onurtoprak1/EE463_PROJECT/Topology of a Simple Battery.png

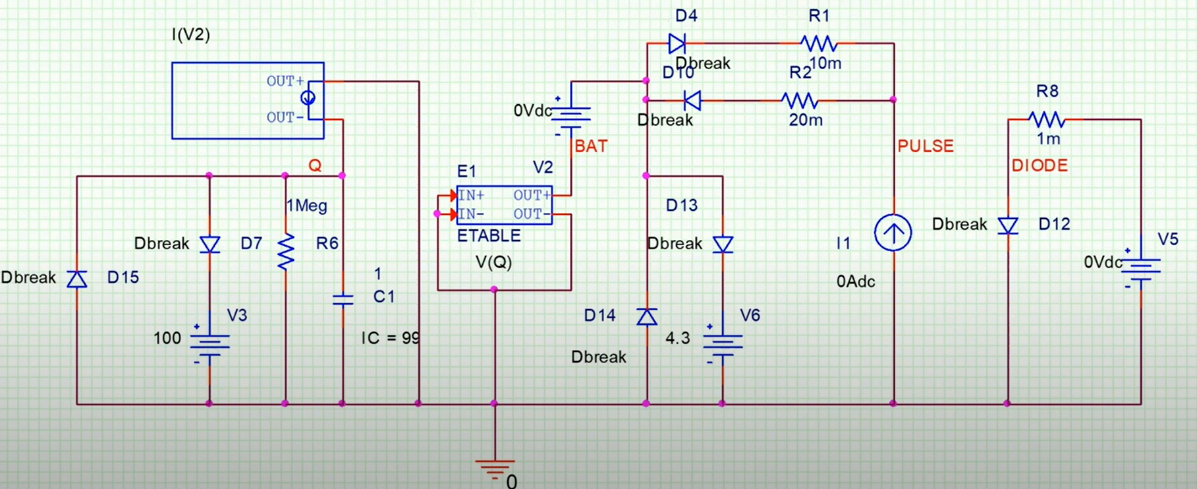
Topology of a Simple Battery.png
