onurtoprak1/EE463_PROJECT/README.md

# EE463_PROJECT
EE463_PROJECT
Advantages and Disadvantages of Three-Phase Thyristor Rectifier Topology:
When it comes to charging batteries, a three-phase thyristor rectifier circuit offers both benefits and drawbacks. On the plus side, it boasts a high efficiency in converting AC to DC power, which reduces energy losses and produces a smoother DC output. Additionally, three-phase rectifiers have a higher power factor and can handle high power loads, making them ideal for applications with substantial power consumption requirements.

However, these advantages come at a cost. Three-phase rectifier circuits are more complex and require additional components, resulting in increased installation and maintenance expenses. Harmful harmonics can also be introduced into the power system, necessitating extra filtering to meet power quality requirements. The control complexity is likewise higher, requiring precise voltage and current regulation for efficient battery charging. Finally, there are other costs to consider, including total cost, upkeep needs, and possible size and weight increases.

Ultimately, whether to use a single-phase or three-phase rectifier will depend on the specific needs of the application, taking into account factors such as space availability, power requirements, and efficiency.
