onurtoprak1/EE463_PROJECT/final report/Implementation.docx

Implementation

Throughout the project, efforts were made to make the design robust and suitable for daily use. The team considered using a PCB board to do this, but decided not to use it due to limited time and knowledge of PCB design. The fully working version of the circuit was tested in various simulation programs and then implemented. The location of the components was determined and optimum lengths were tried to be selected in terms of signal transmission. Heat sinks were adjusted by paying attention to thermal calculations, but the component positions on the stripboard could not be completed in time and soldered in a neat position due to limited time and the difficulties of pure analog design. Under these conditions, the overall circuit, rectifier - controller and output parts were positioned on separate pertinaxes and taken to the demo in this way.

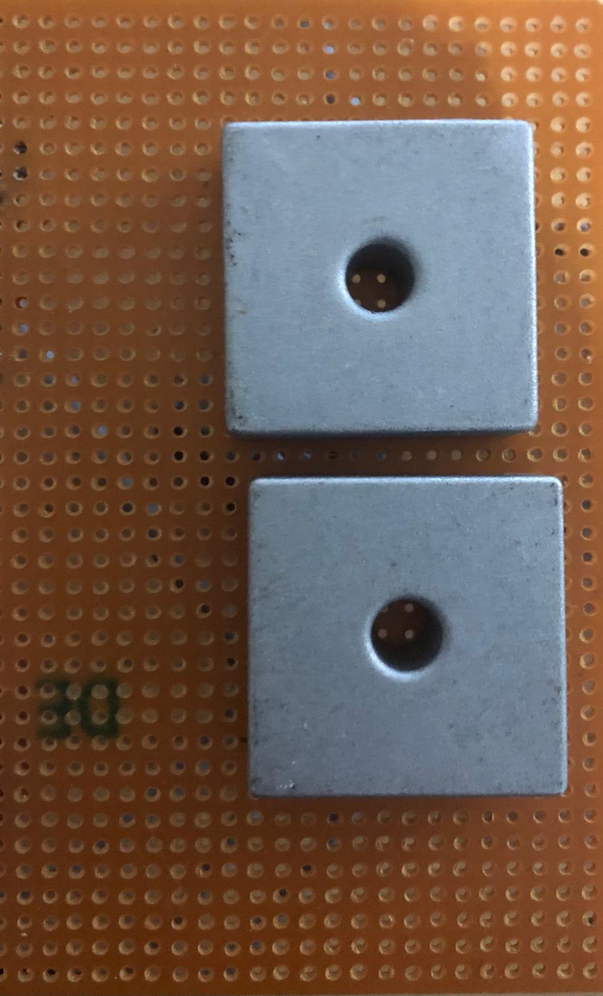
[picture p15: figure]
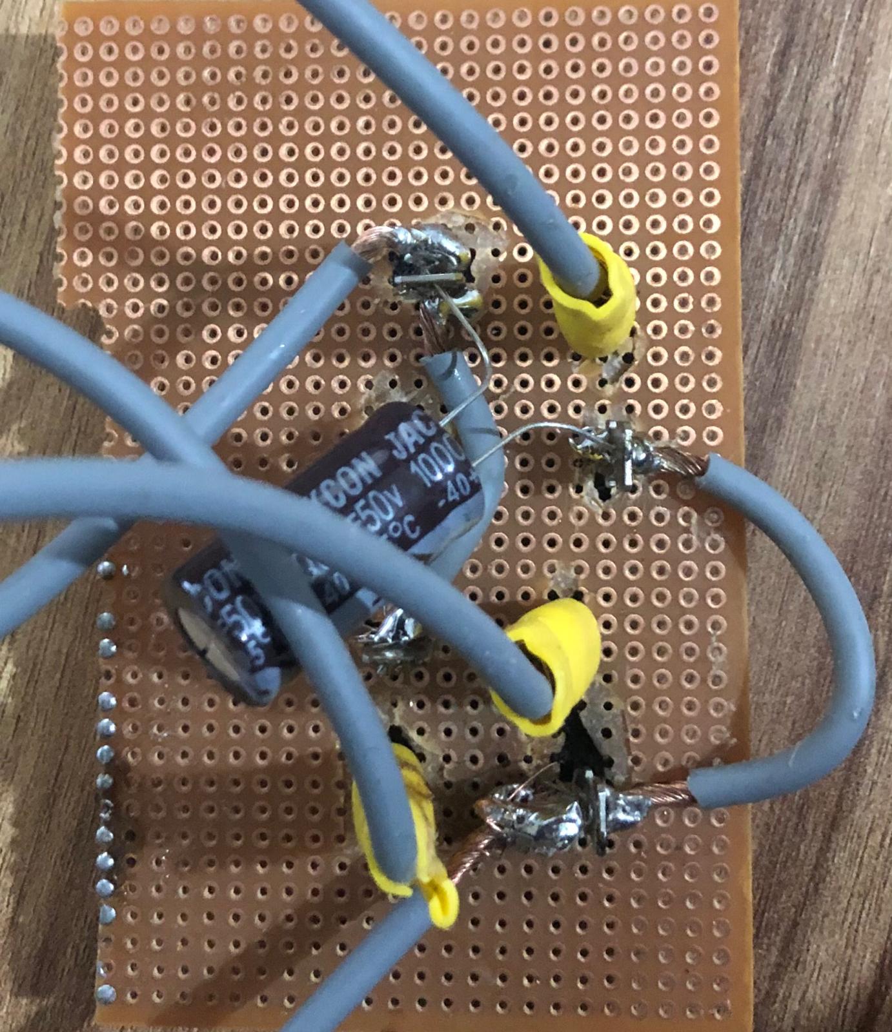
[picture p16: figure]
kablo, Elektrik kabloları, mühendislik, elektronik mühendisliği içeren bir resim Açıklama otomatik olarak oluşturuldu

Figure a. Front and Back Side of Rectifier

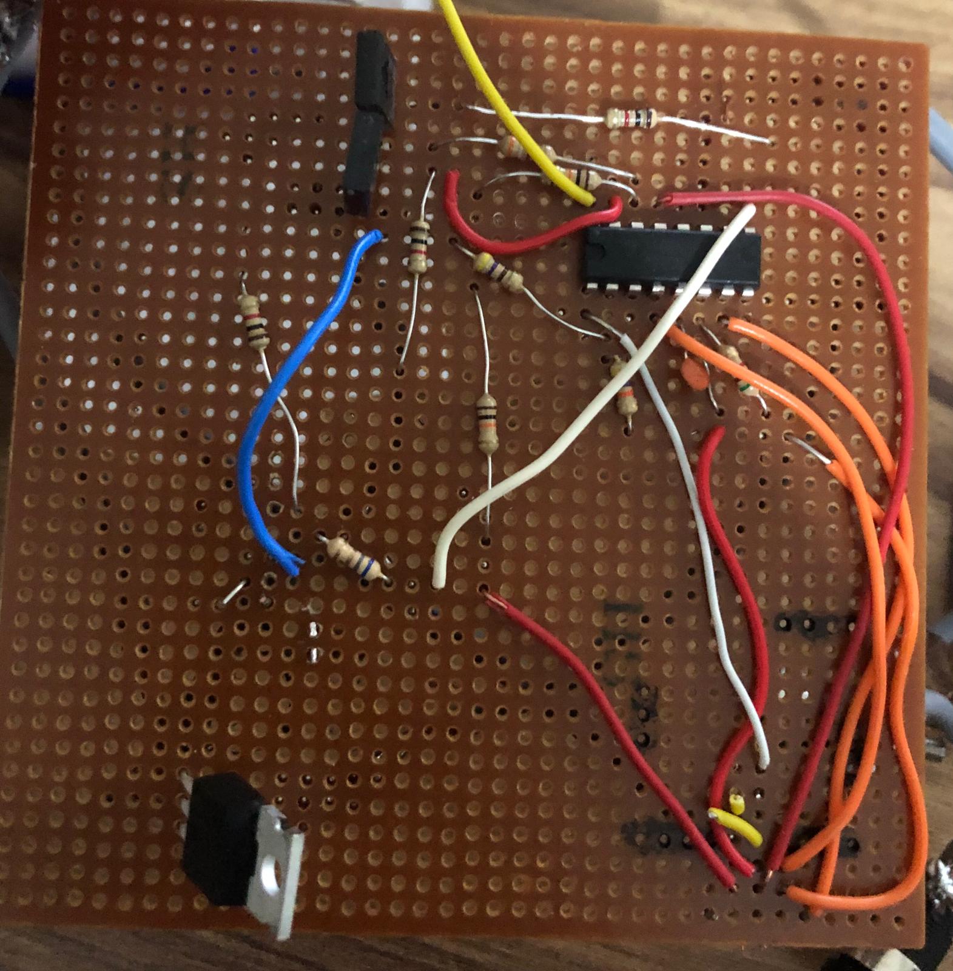
[picture p17: figure]
Elektrik kabloları, elektronik mühendisliği, elektronik donanım, kablo içeren bir resim Açıklama otomatik olarak oluşturuldu

Figure b. Front Side of Controller Part

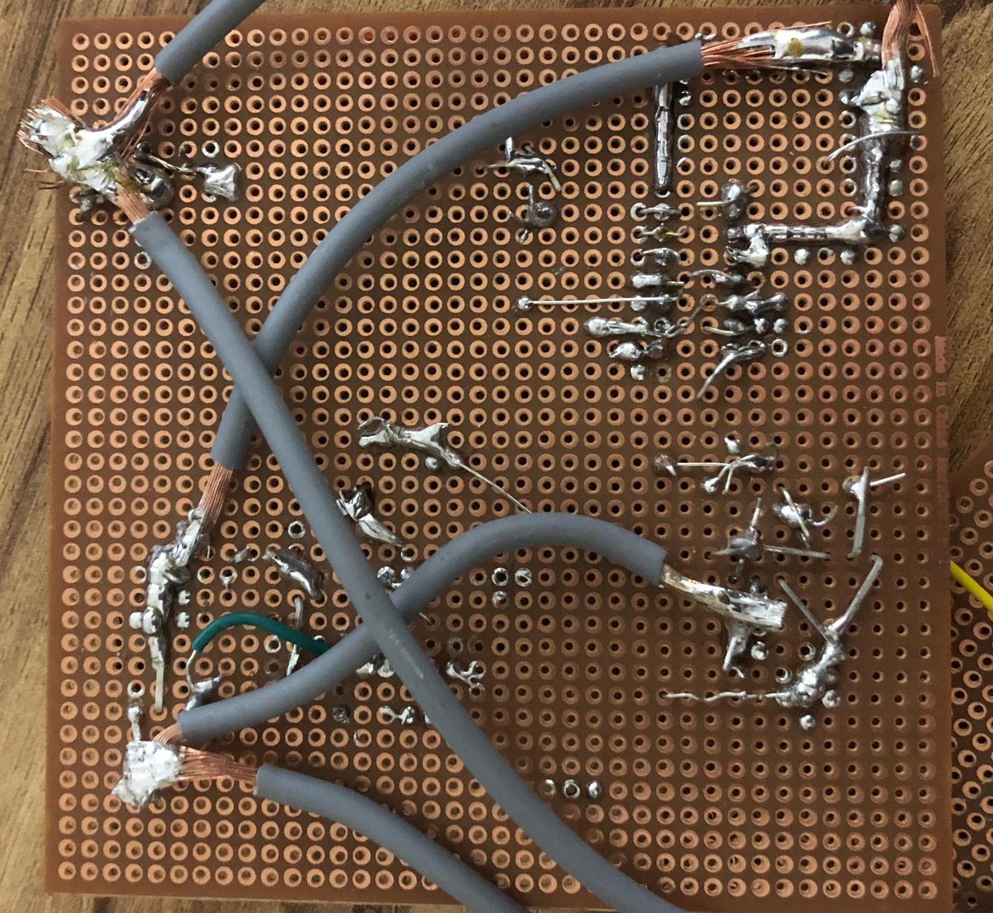
[picture p18: figure]
Elektrik kabloları, elektronik mühendisliği, elektronik bileşen, devre bileşeni içeren bir resim Açıklama otomatik olarak oluşturuldu

Figure c. Back Side of Controller Part

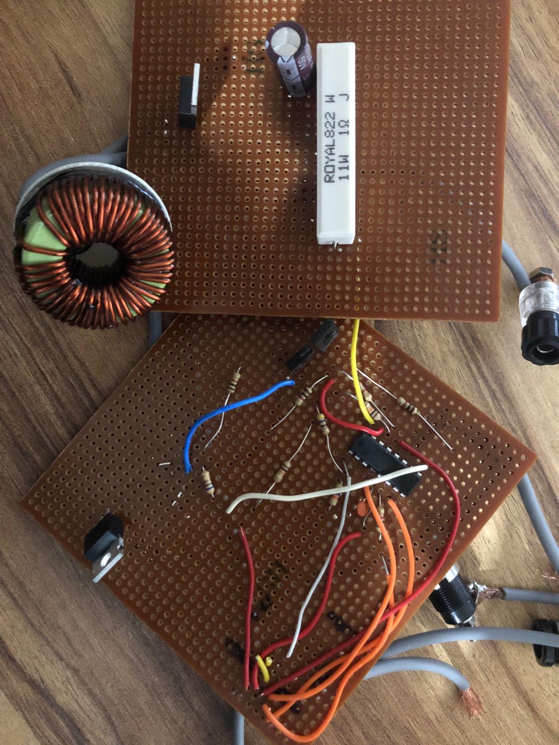
[picture p19: figure]
Elektrik kabloları, elektronik donanım, devre bileşeni, elektronik mühendisliği içeren bir resim Açıklama otomatik olarak oluşturuldu

Figure d. Overall Charger Circuit
