onurtoprak1/EE463_PROJECT/simulation_report/simu presentation.pptx

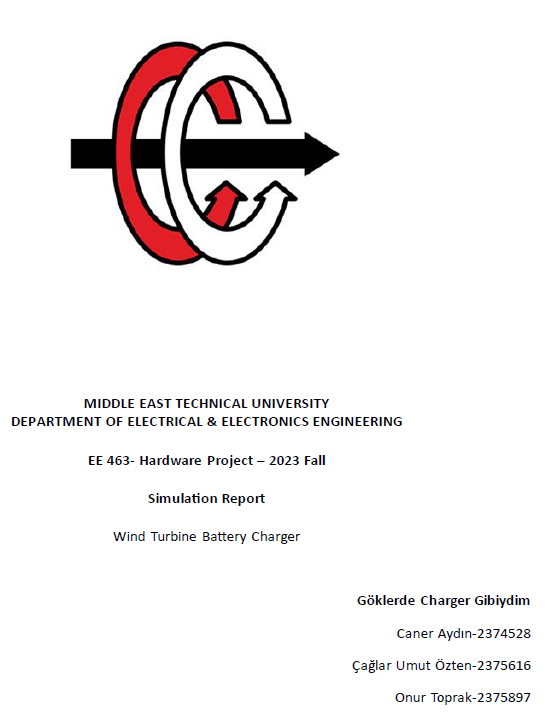
[picture p44: figure]

## OUTLINE

- Battery Illustration
- Topology Selection
- Simulations
- PWM Generator
- Component Selection
- Bonus Parts

## Charging types of battery

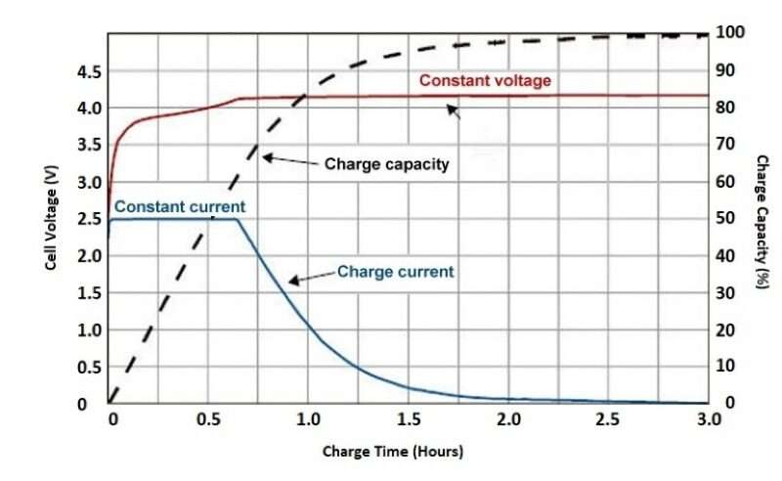
[picture p45: figure]

## Slide 4

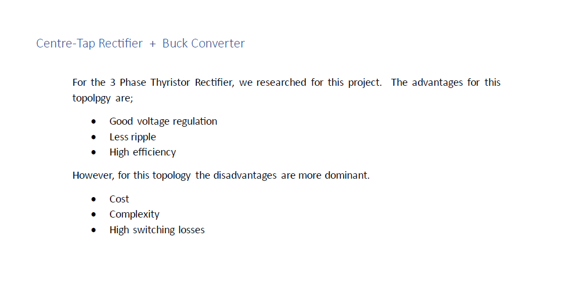
[picture p46: figure]

## Slide 5

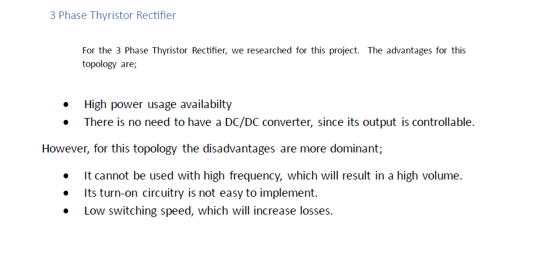
[picture p47: figure]

## Slide 6

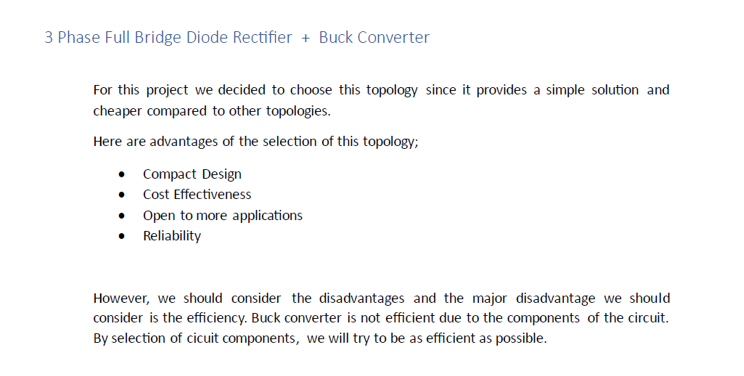
[picture p48: figure]

## Slide 7

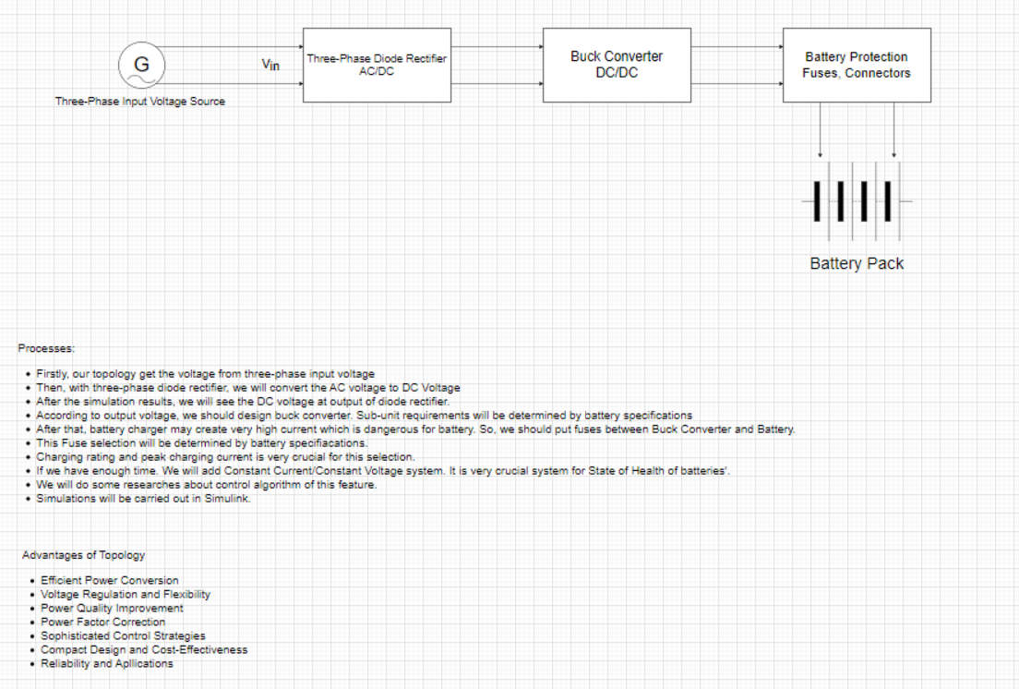
[picture p49: figure]

## Overall Circuit Schematic for Battery Charger

## Diode Current Waveforms (Maximum Input Voltage) and Diode Voltage Waveforms (Maximum Input Voltage)

## Output Voltage Waveforms , Output Voltage Waveforms (Maximum Input Voltage)

## Buck converter circuit

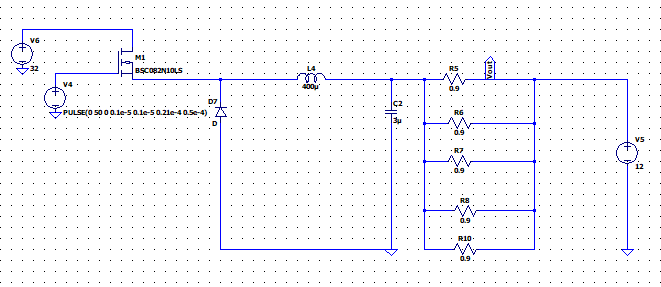
[picture p50: figure]

## Output Voltage Waveform of Buck Converter

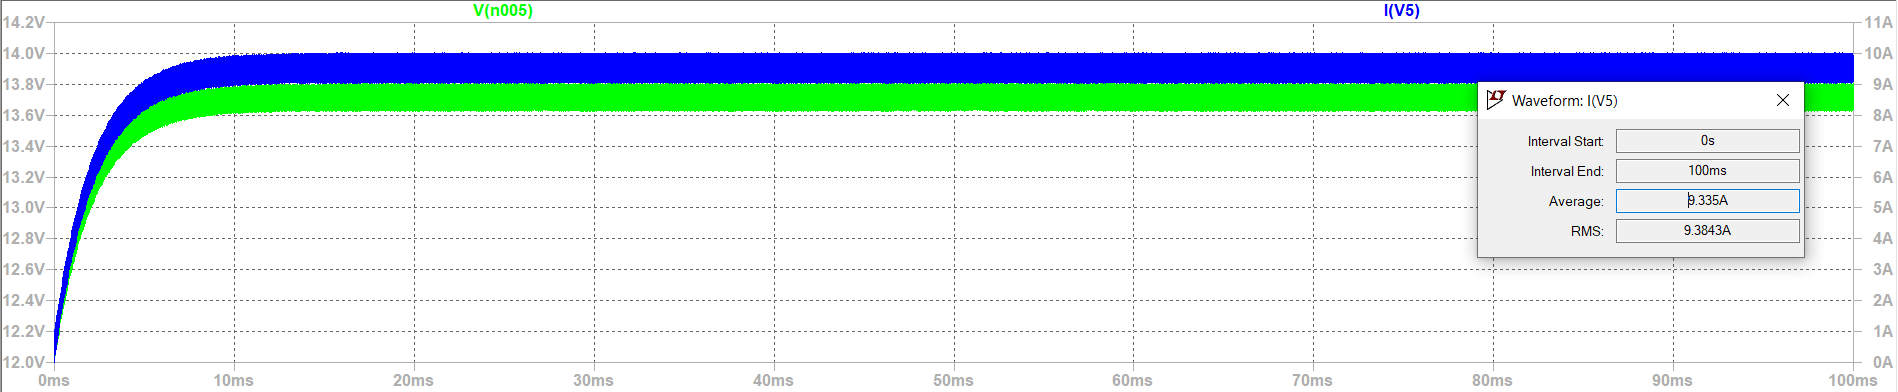
[picture p51: figure]

## Buck Converter Voltage and Current Waveform of Inductor and Diode

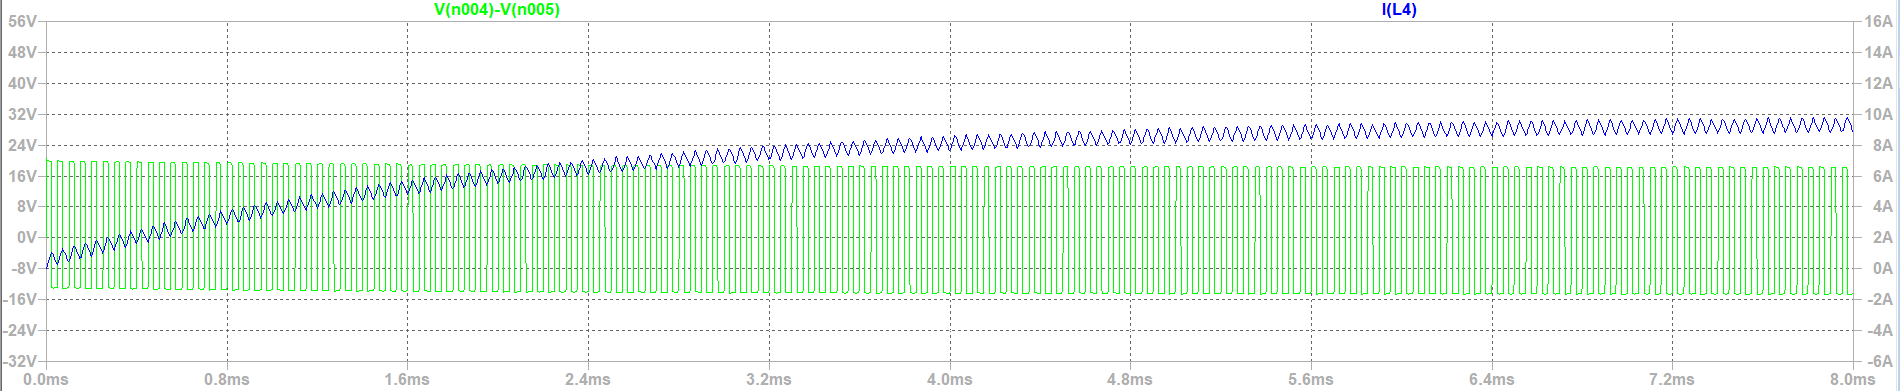
[picture p52: figure]
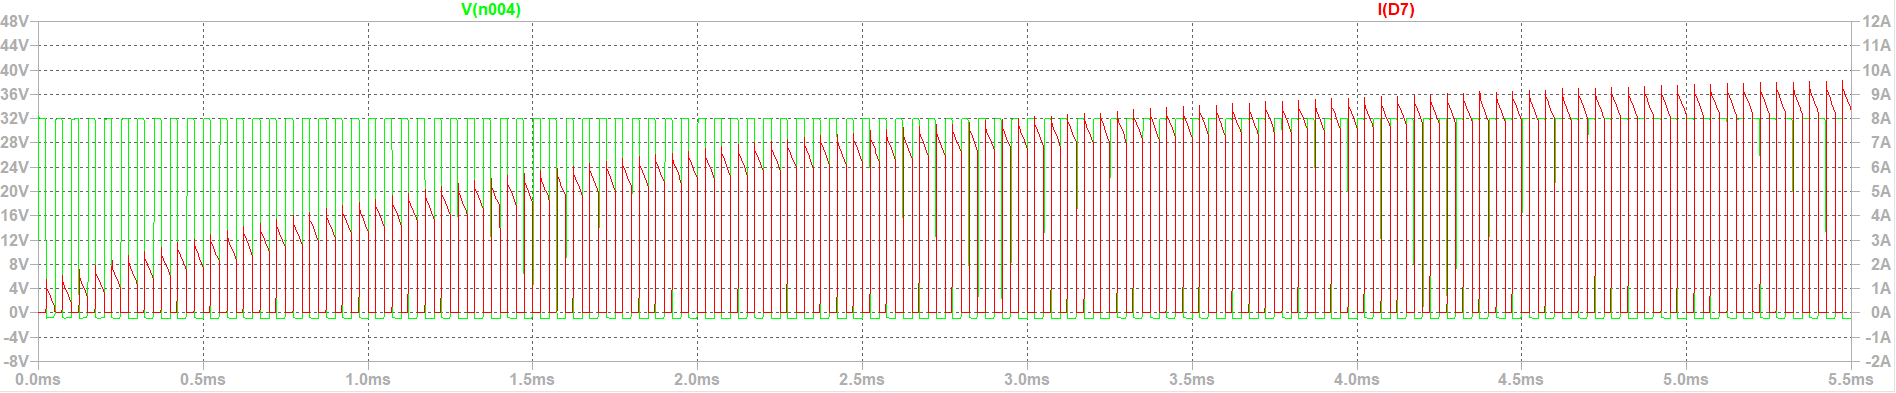
[picture p53: figure]

## MOSFET Current Waveform (Id)

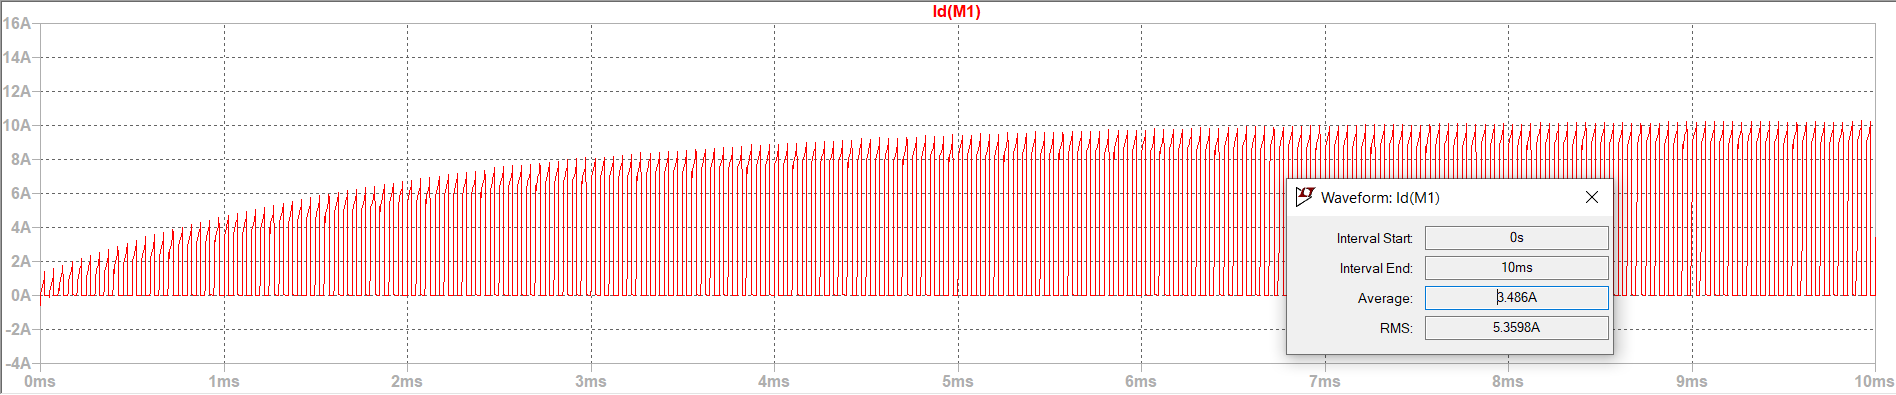
[picture p54: figure]

## Gate Signal

## Timer Circuit LM555

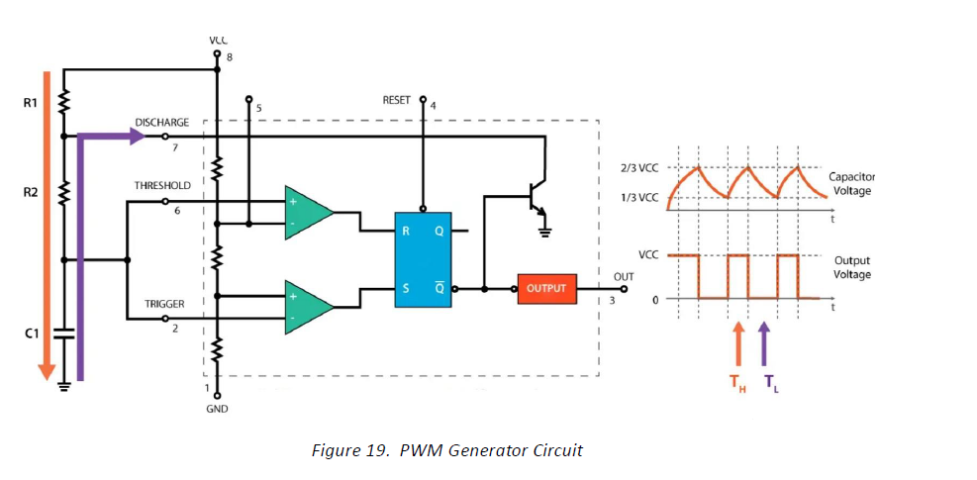
[picture p55: figure]
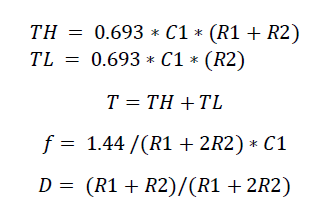
[picture p56: figure]

## Controller Circuit

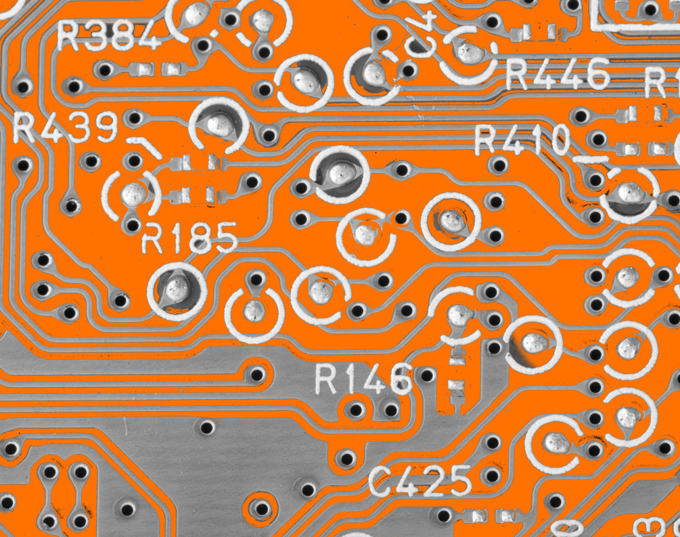
[picture p57: figure]
Electronic circuit board with processor

TL494 VOLTAGE REGULATOR

- Integrated Controller Circuit
- Feedback from battery to keep Id 10 A constant.
- Voltage regulator at the end with resistor or a regulator

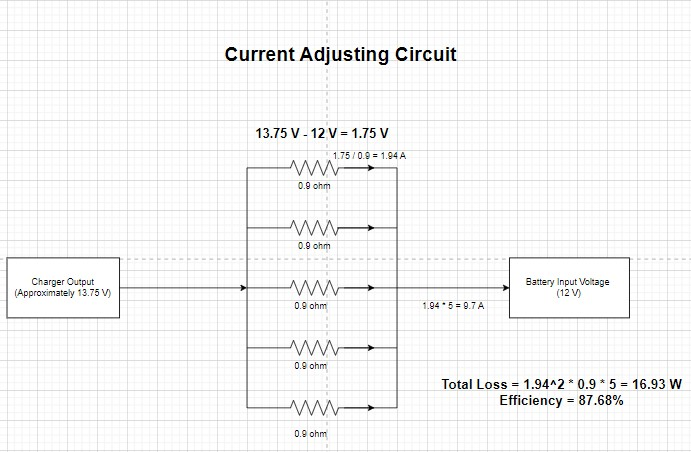
[picture p58: figure]
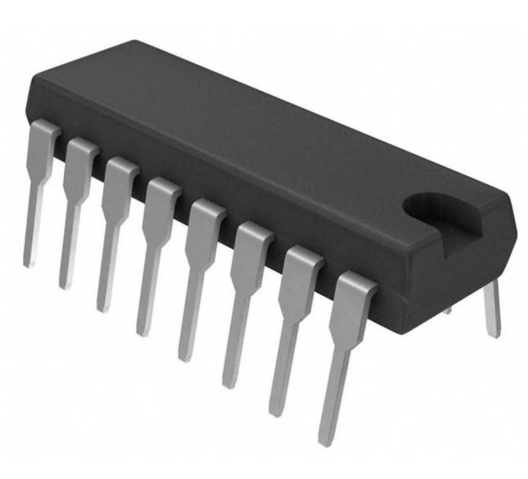
[picture p59: figure]

## Component Selection

- Diode

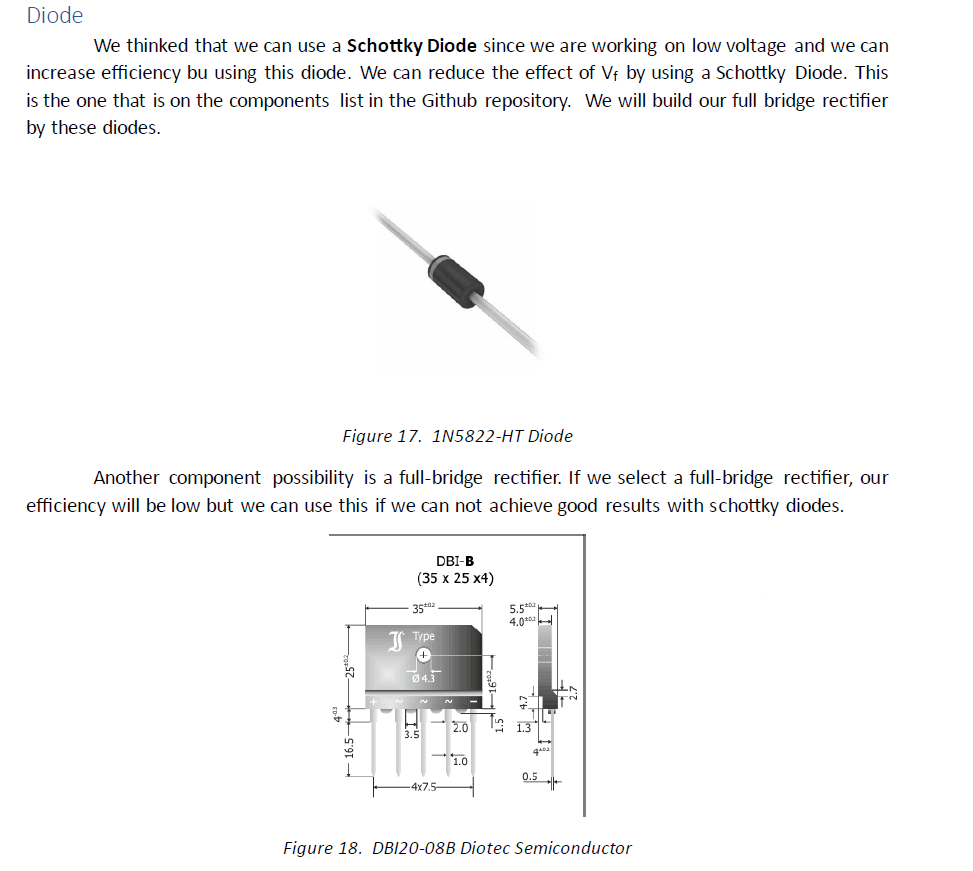
[picture p60: figure]
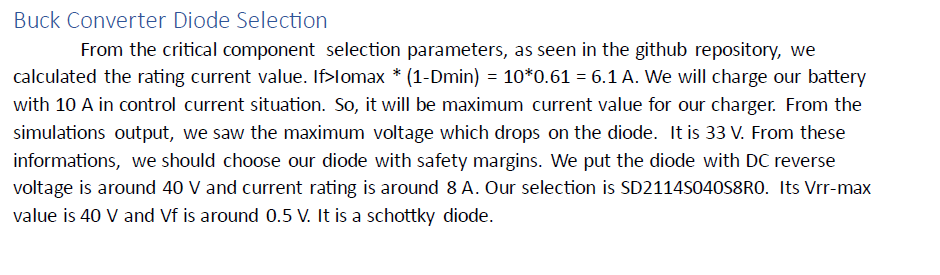
[picture p61: figure]
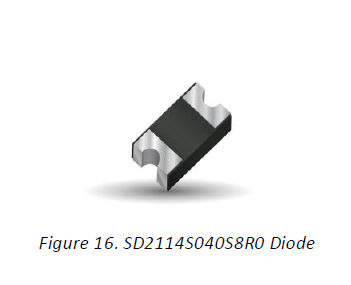
[picture p62: figure]

## BUCK CONVERTER DIODE

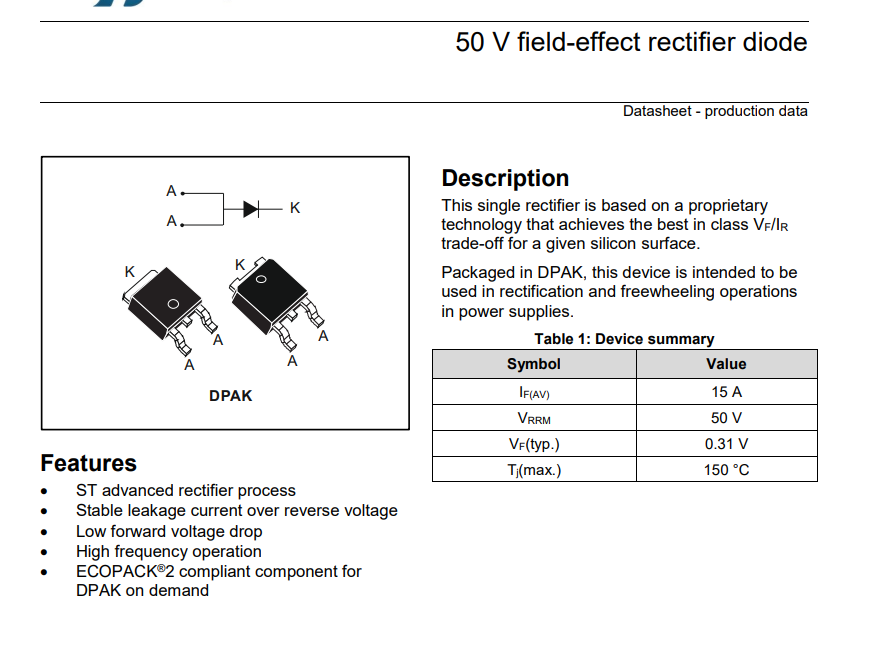
[picture p63: figure]
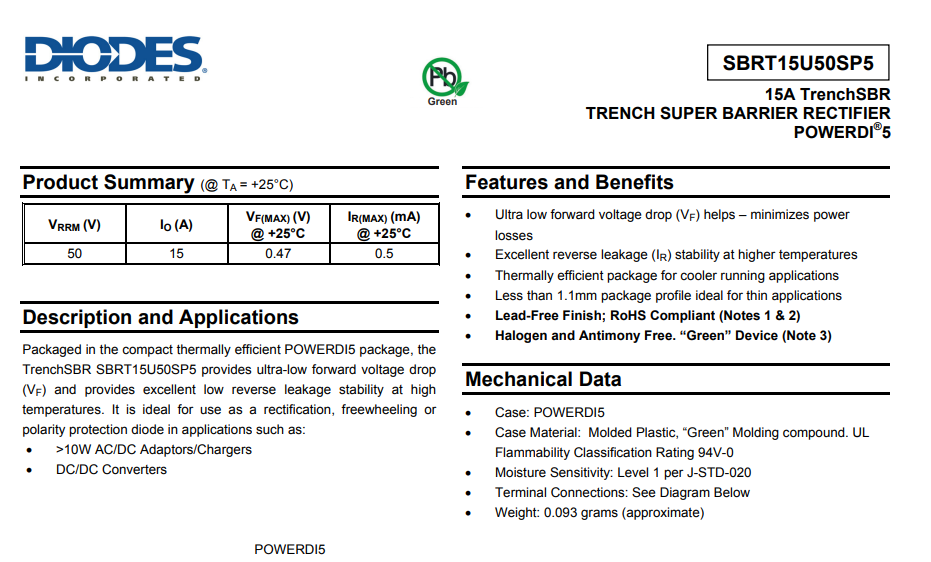
[picture p64: figure]

## Slide 20

- MOSFET

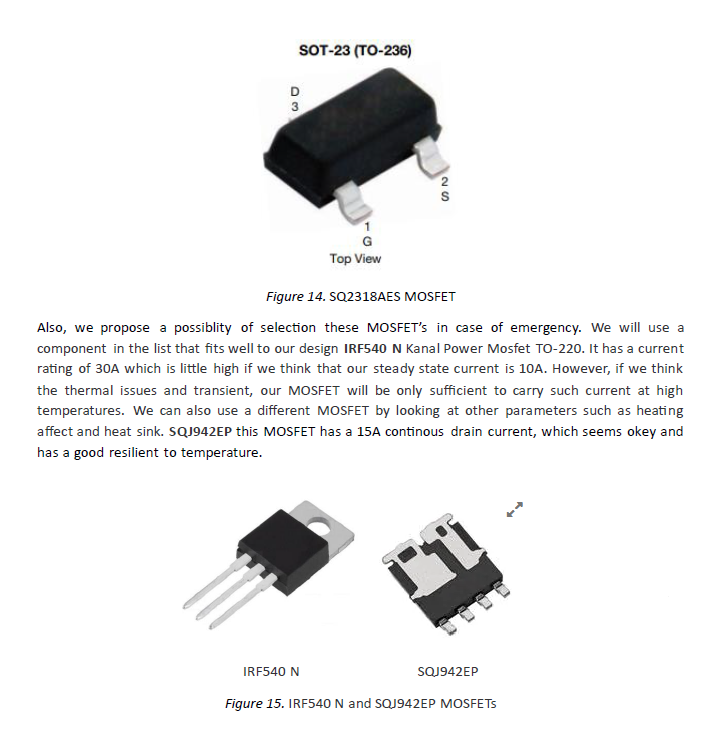
[picture p65: figure]
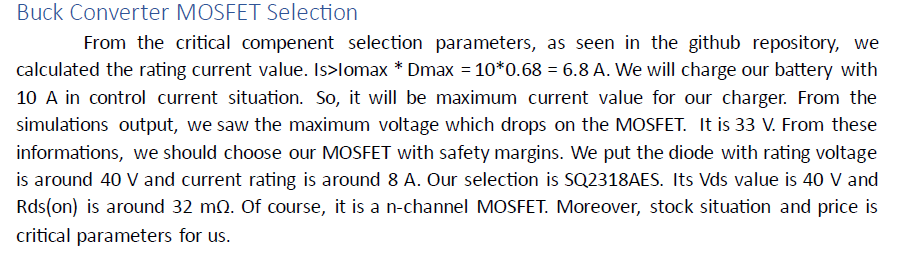
[picture p66: figure]

IRF 540 N Mosfet 100V 28A

## MOSFET

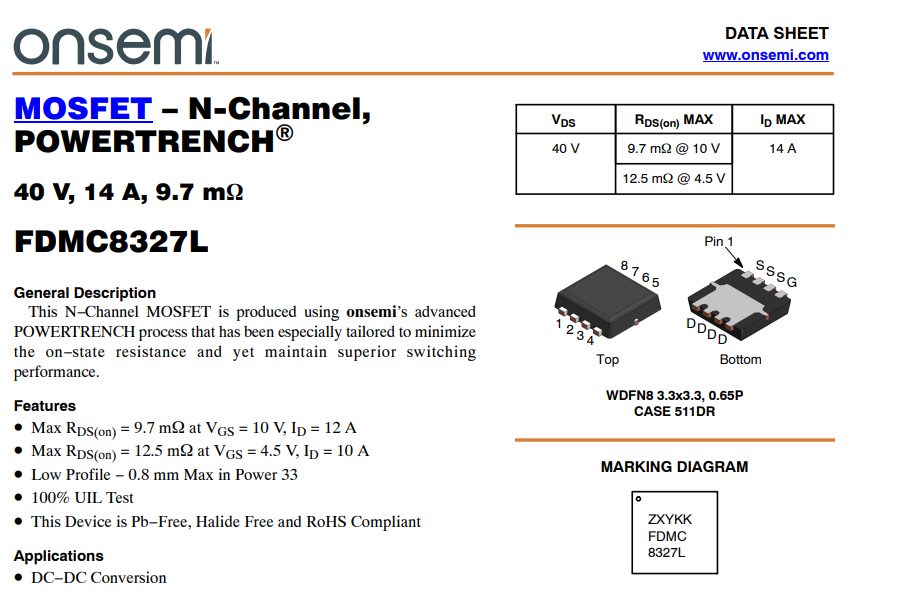
[picture p67: figure]
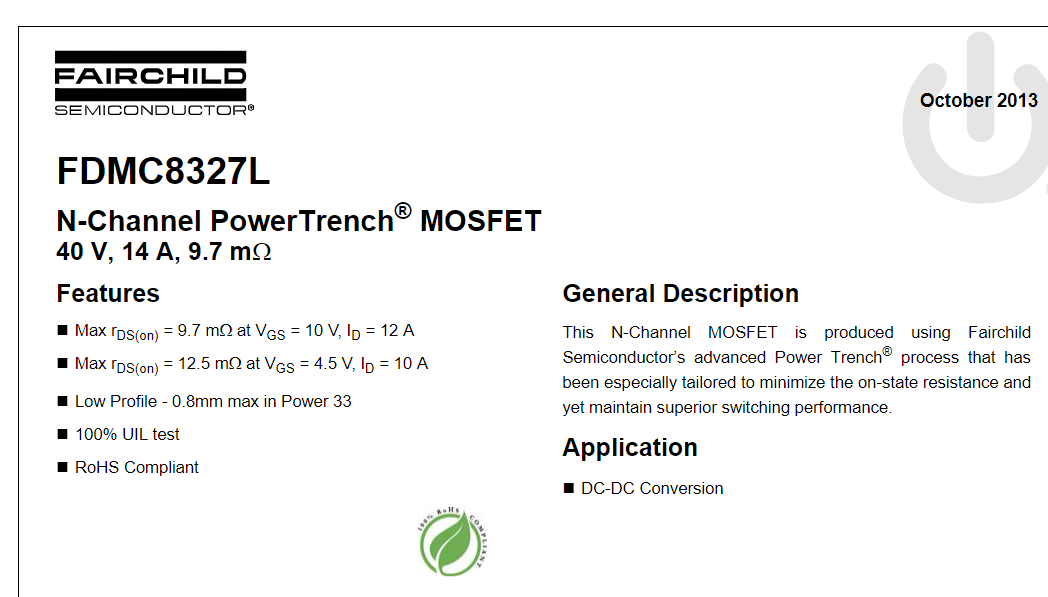
[picture p68: figure]

## Slide 22

## BONUS

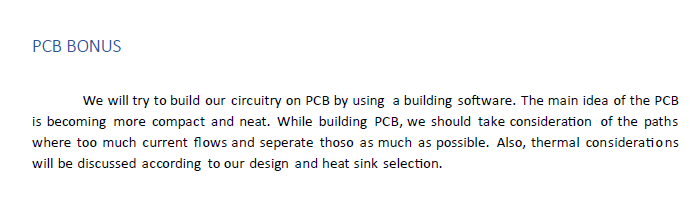
[picture p69: figure]
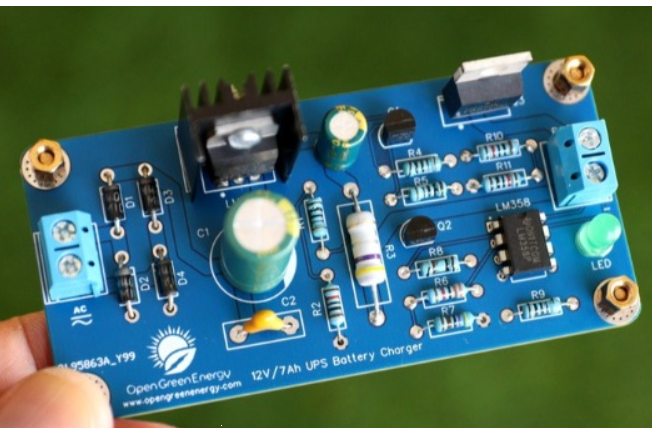
[picture p70: figure]
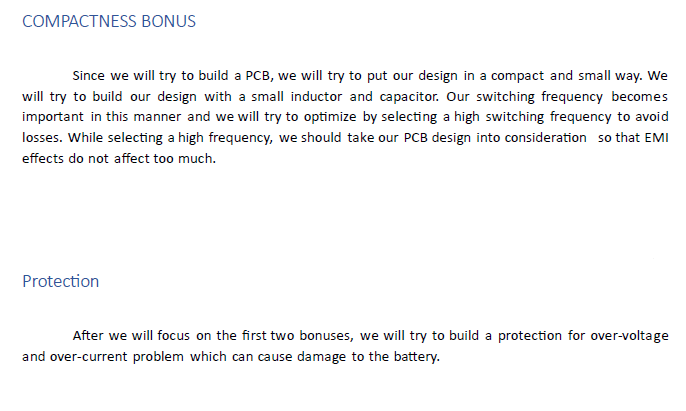
[picture p71: figure]
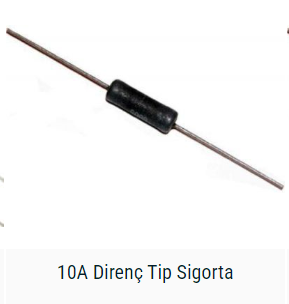
[picture p72: figure]
