onurtoprak1/EE463_PROJECT/efficiency improvement ways.pdf

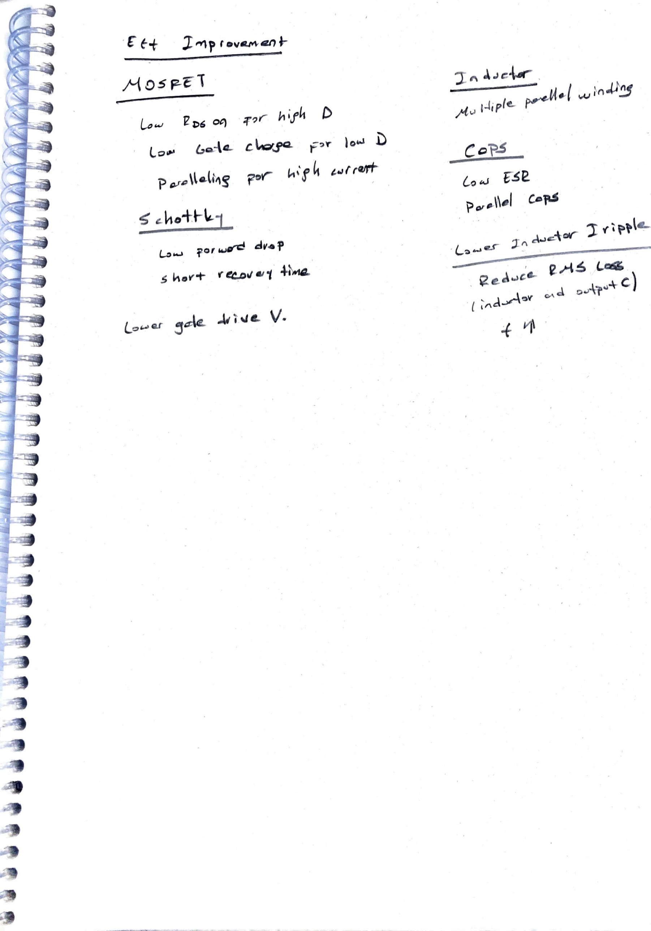
[picture p90: page 1]

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
(.,c..ı l? t>ıS otı 1"?r l-t ifk D
L".. t,0--\a. cı..,,,J">- f'' I•"' i:) P .,#1I..ıı~s "..,.. ı..;f tı ..,,,oırt

~..... :ı2or ıı.ı;d dv.of
S lı\of~ 'f ~J .ı i ,h'wtQ..

'l-" ~ .., e; ı.,--
-,.ı , ,~;pi ... ;:,.,u .. t .., wV'.!1

---'

,

'2. e. ..ıd,._ e,.M6 ~ ; A .;fi., ~ .ı . A1•"'" C)
