onurtoprak1/EE463_PROJECT/1m cap load.PNG

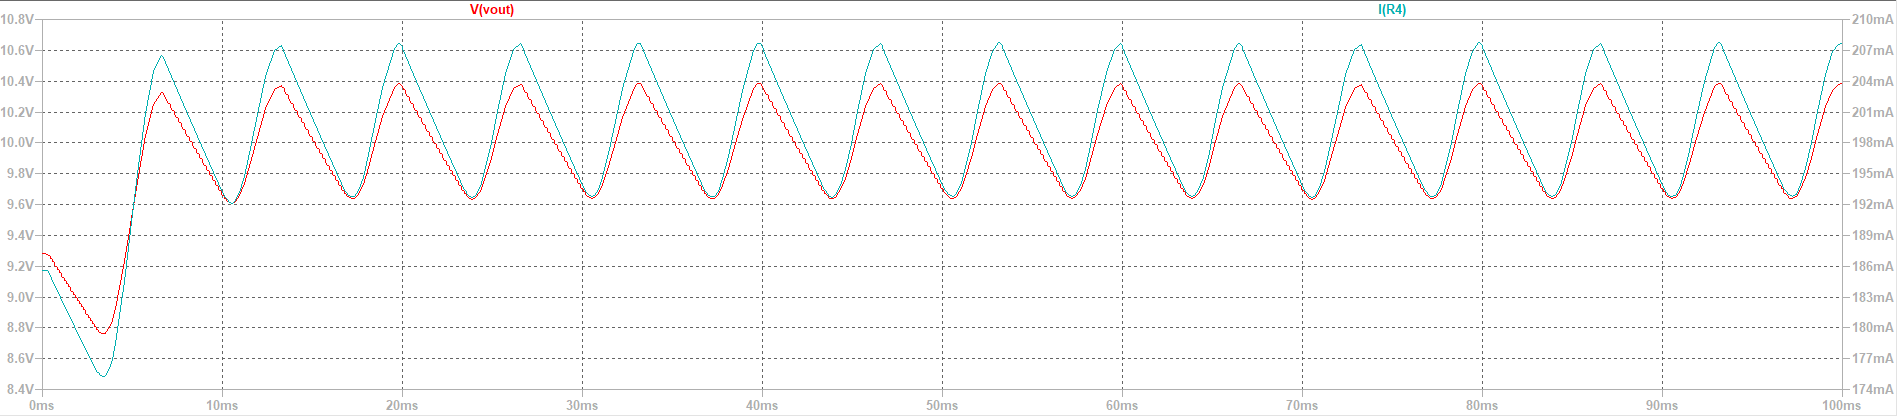
1m cap load.PNG
