onurtoprak1/EE463_PROJECT/1n capacitor load.PNG

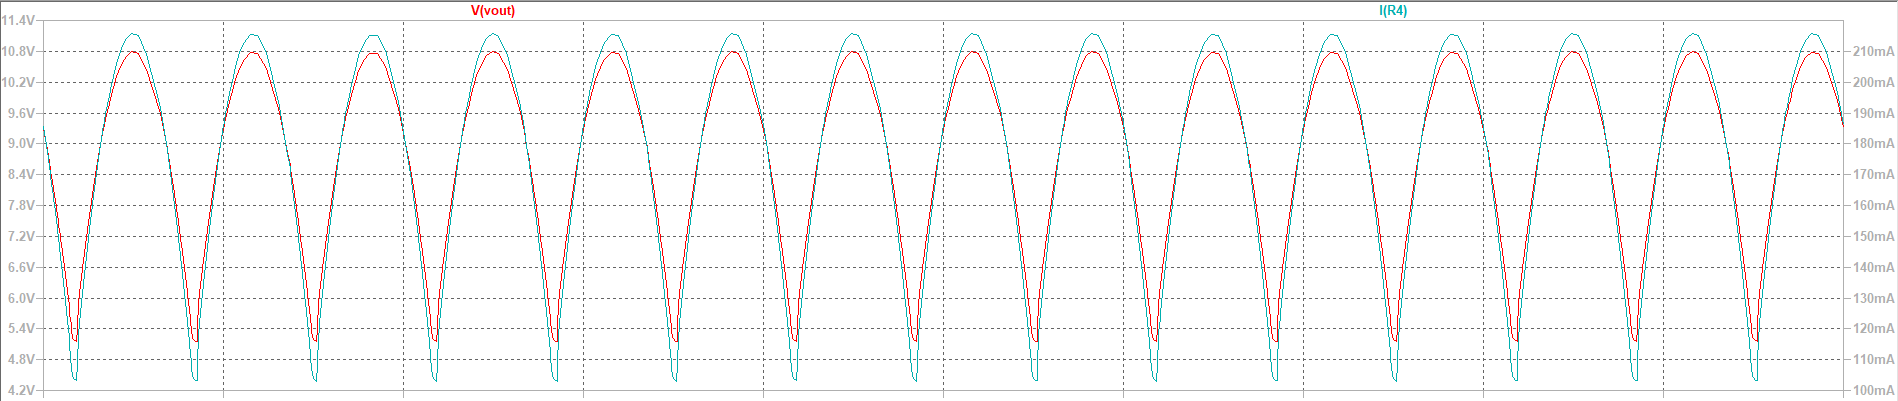
1n capacitor load.PNG
