onurtoprak1/EE463_PROJECT/3PTR.png

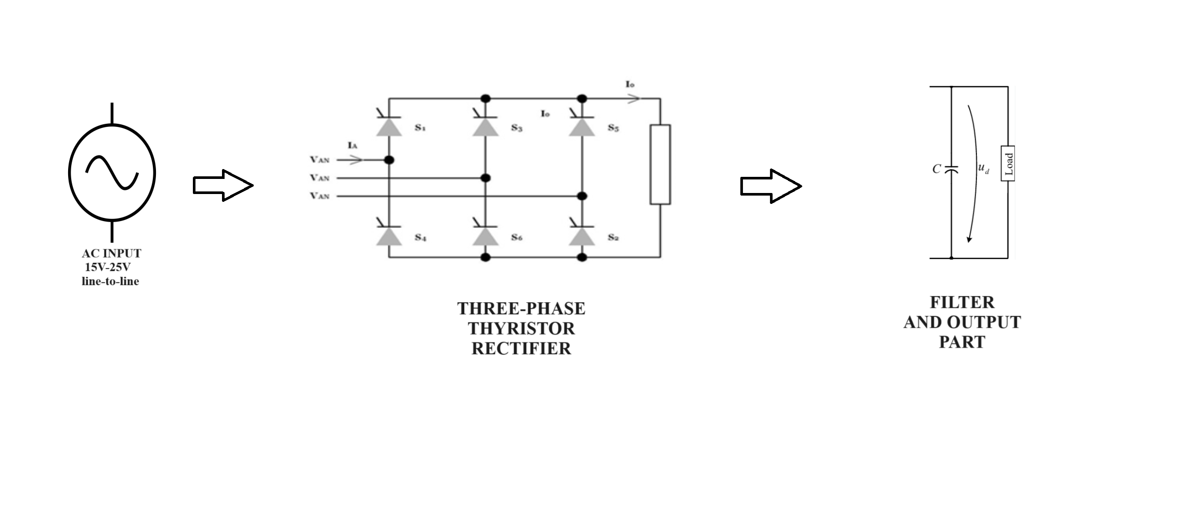
3PTR.png
