onurtoprak1/EE463_PROJECT/19V input voltage output values.PNG

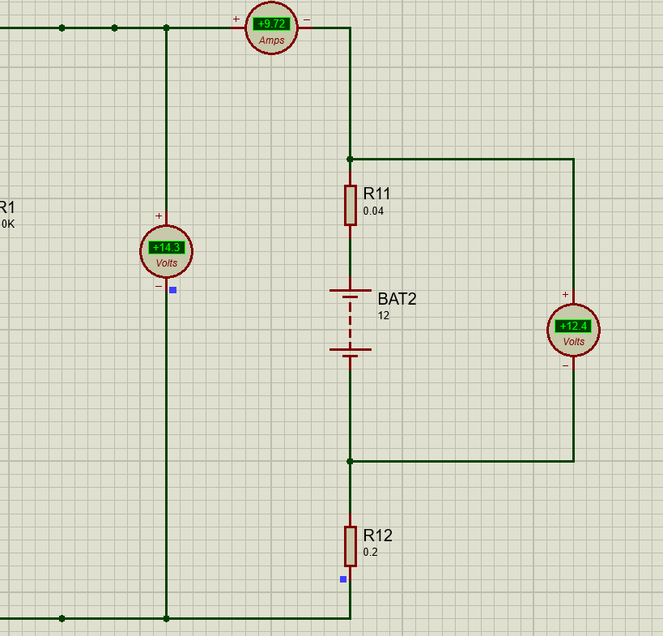
19V input voltage output values.PNG
