onurtoprak1/EE463_PROJECT/19V oscilloscope Screen.PNG

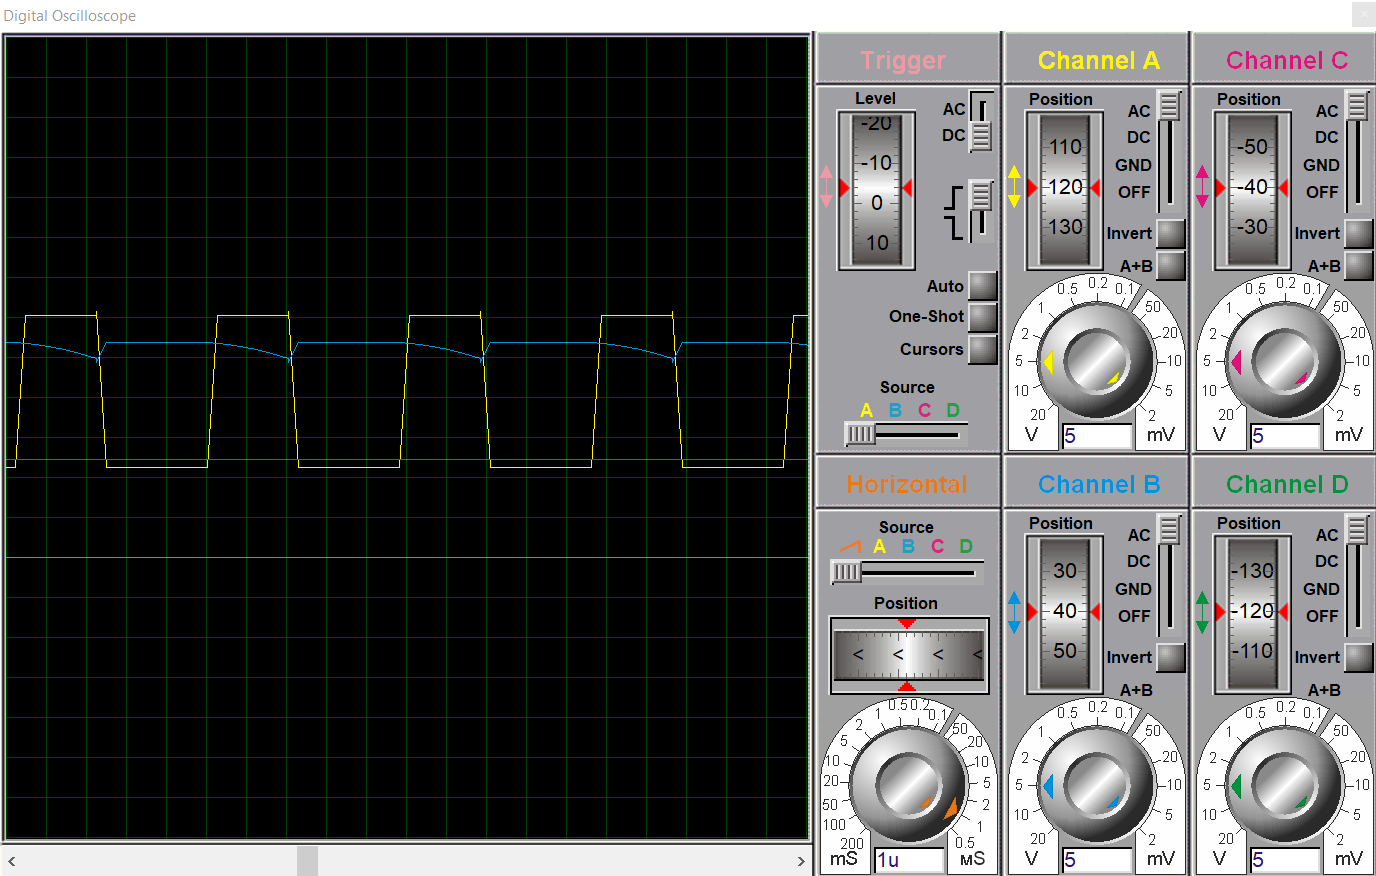
19V oscilloscope Screen.PNG
