onurtoprak1/EE463_PROJECT/33V input case output values.PNG

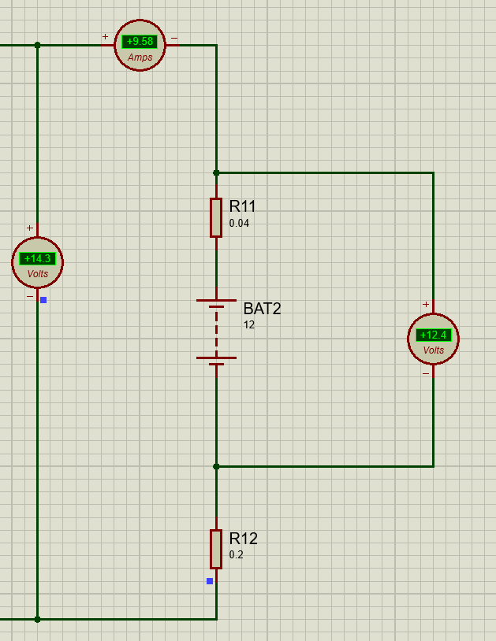
33V input case output values.PNG
