onurtoprak1/EE463_PROJECT/33V oscilloscope Screen.PNG

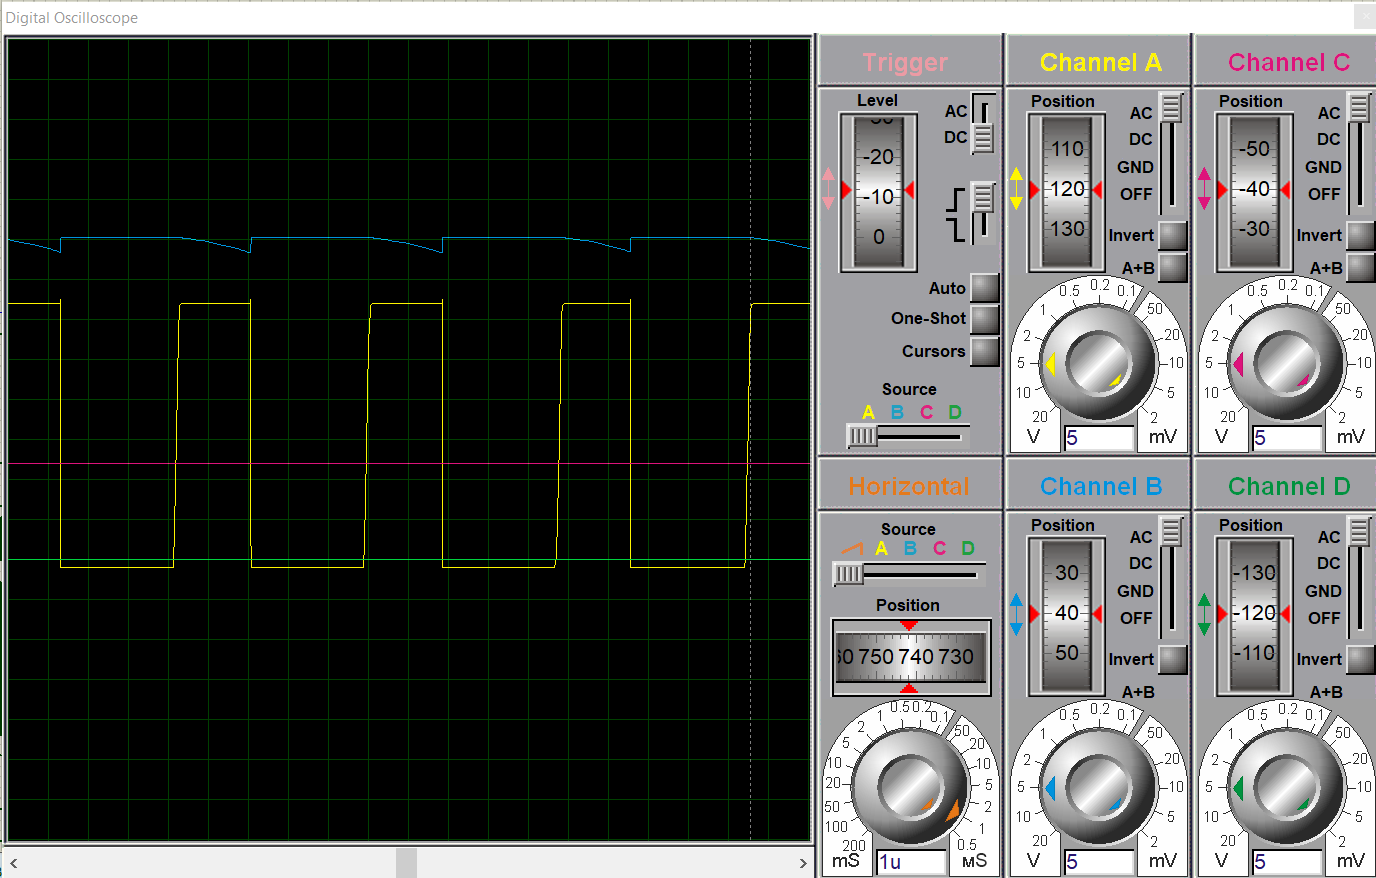
33V oscilloscope Screen.PNG
