onurtoprak1/EE463_PROJECT/Buck Converter Last Design.PNG

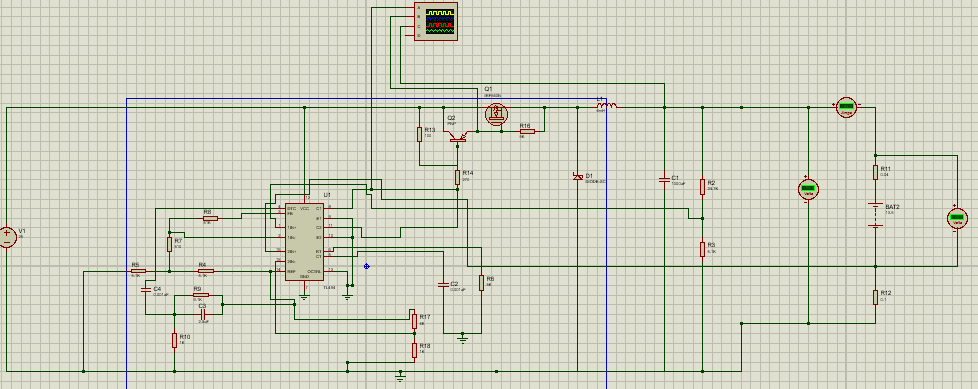
Buck Converter Last Design.PNG
