onurtoprak1/EE463_PROJECT/Centre-tap rectifier diagram.PNG

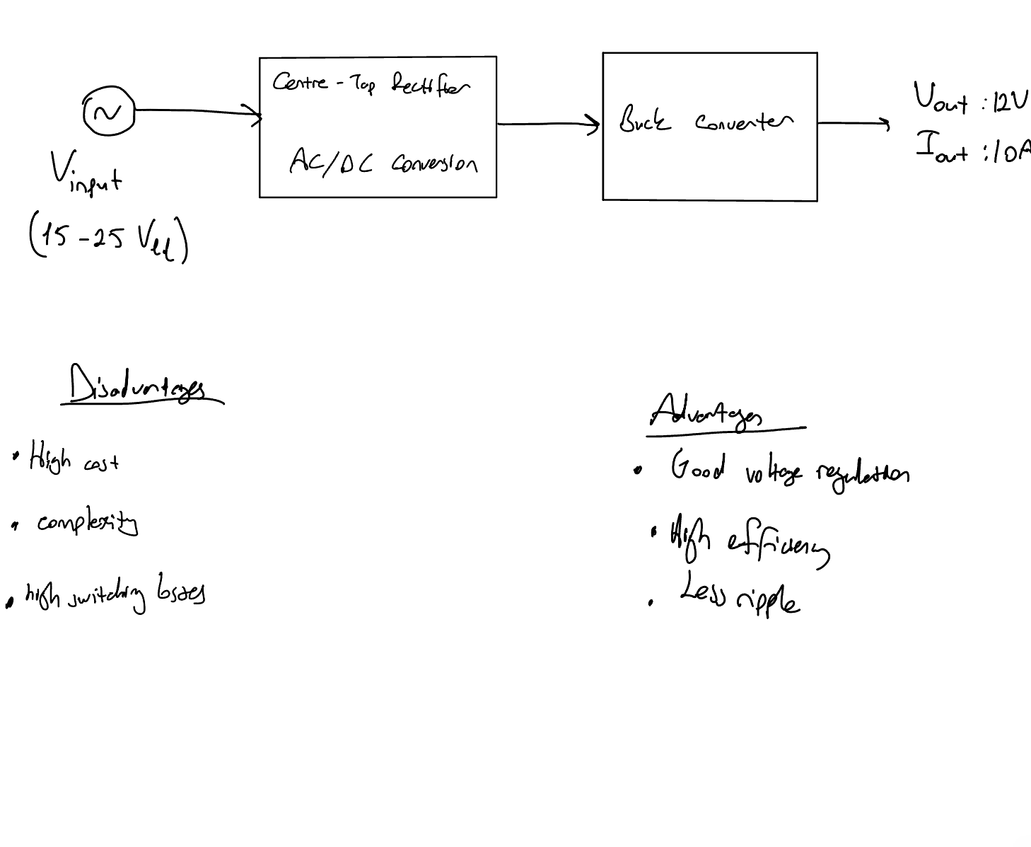
Centre-tap rectifier diagram.PNG
