onurtoprak1/EE463_PROJECT/current circuit.PNG

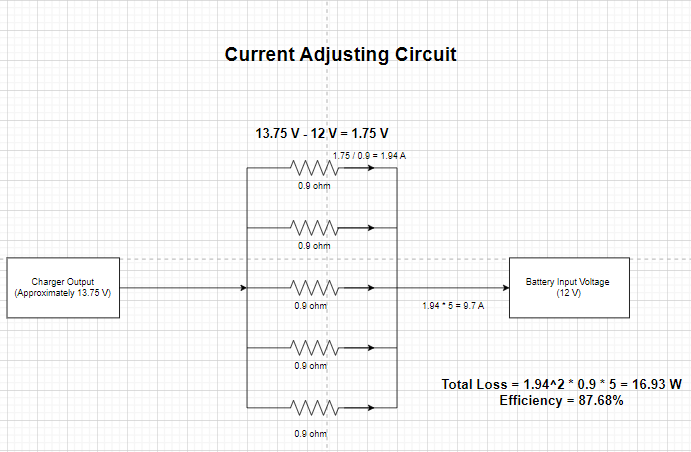
current circuit.PNG
