onurtoprak1/EE463_PROJECT/CurrentAdjusting.png

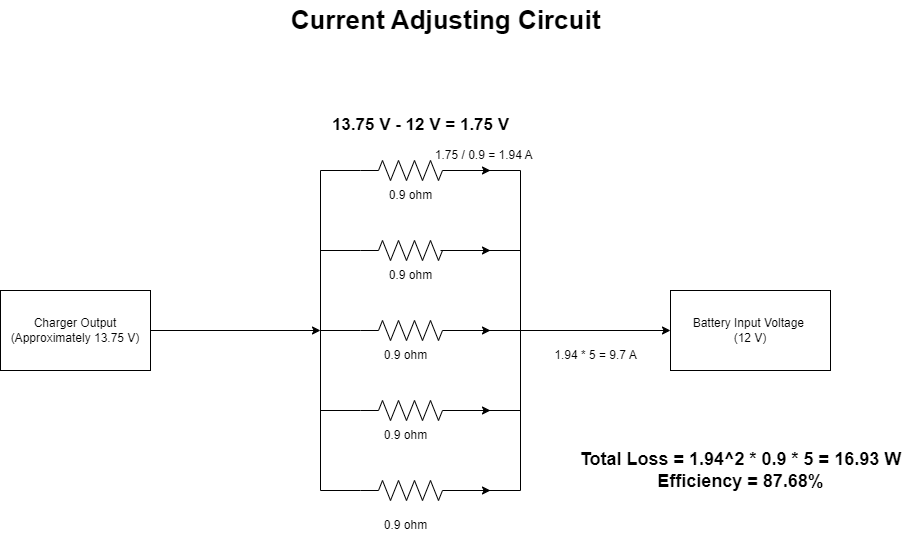
CurrentAdjusting.png
