onurtoprak1/EE463_PROJECT/overall topology simulation.PNG

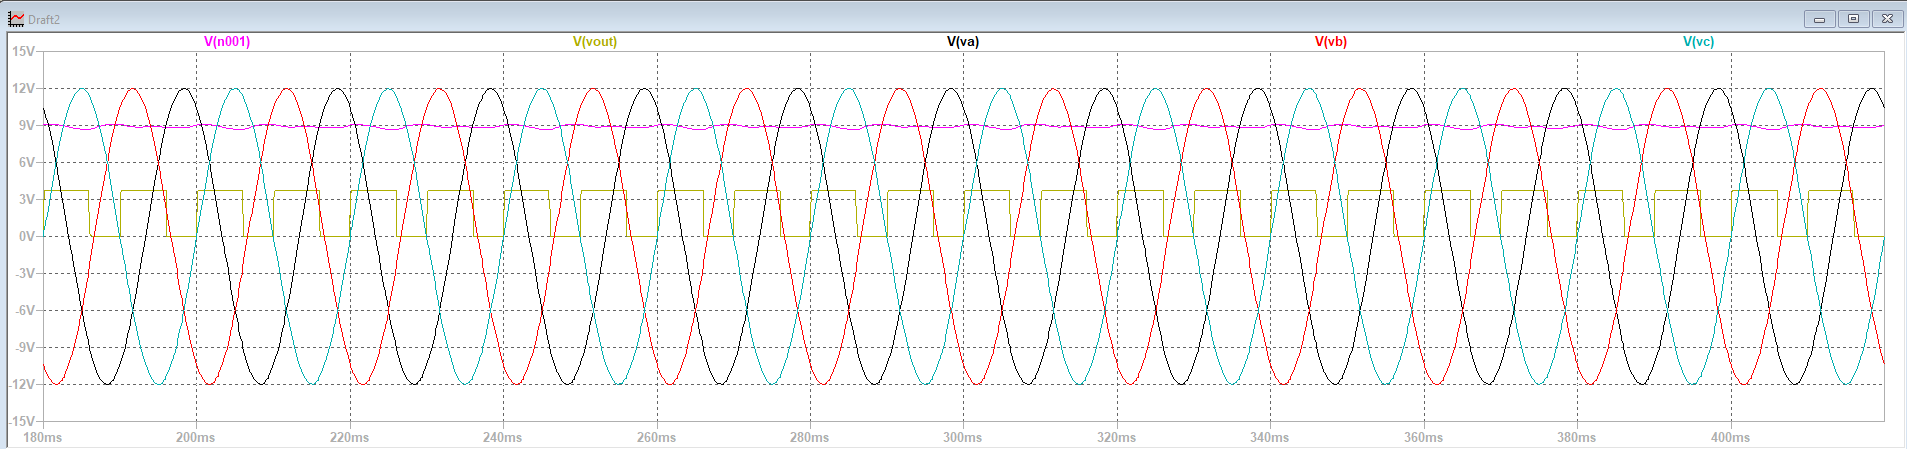
overall topology simulation.PNG
