onurtoprak1/EE463_PROJECT/PWM Generator circuit with 555 Timer 2.png

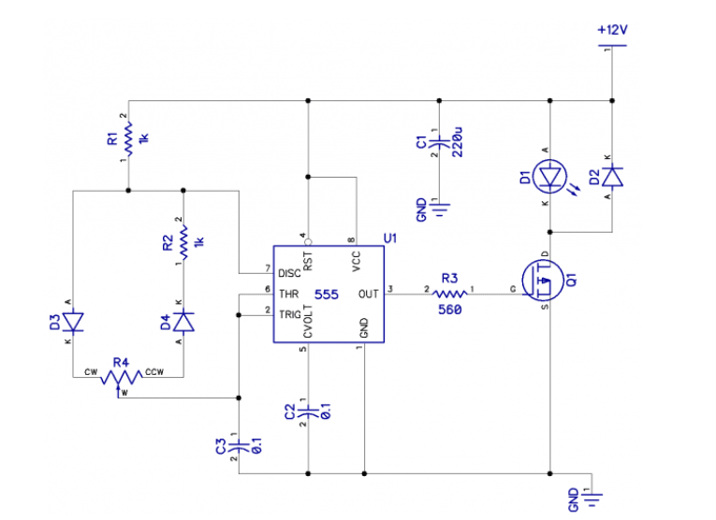
PWM Generator circuit with 555 Timer 2.png
