onurtoprak1/EE463_PROJECT/PWM Generator circuit with 555 Timer.png

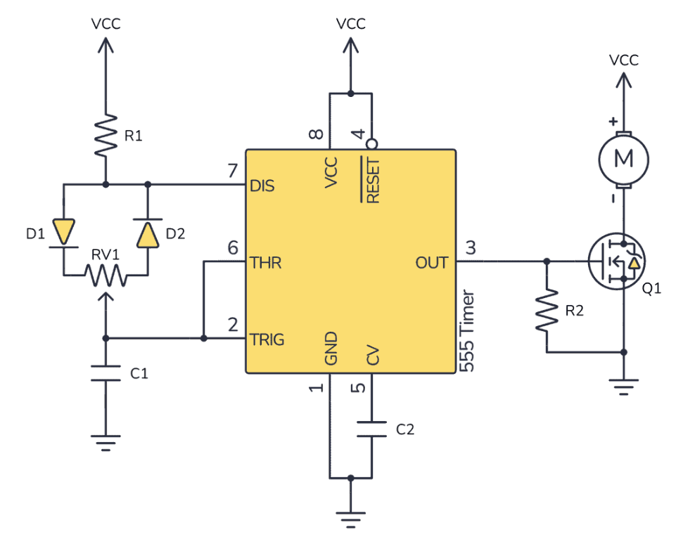
PWM Generator circuit with 555 Timer.png
