onurtoprak1/EE463_PROJECT/Teardown of a 555 Timer.png

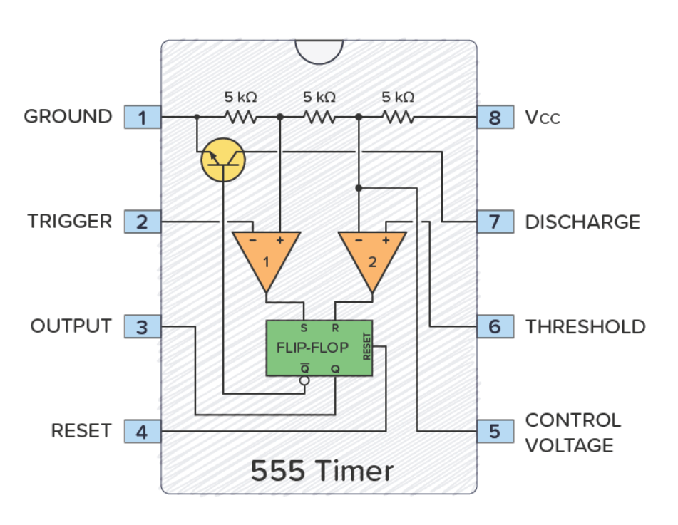
Teardown of a 555 Timer.png
