onurtoprak1/EE463_PROJECT/thyristor with pulse.png

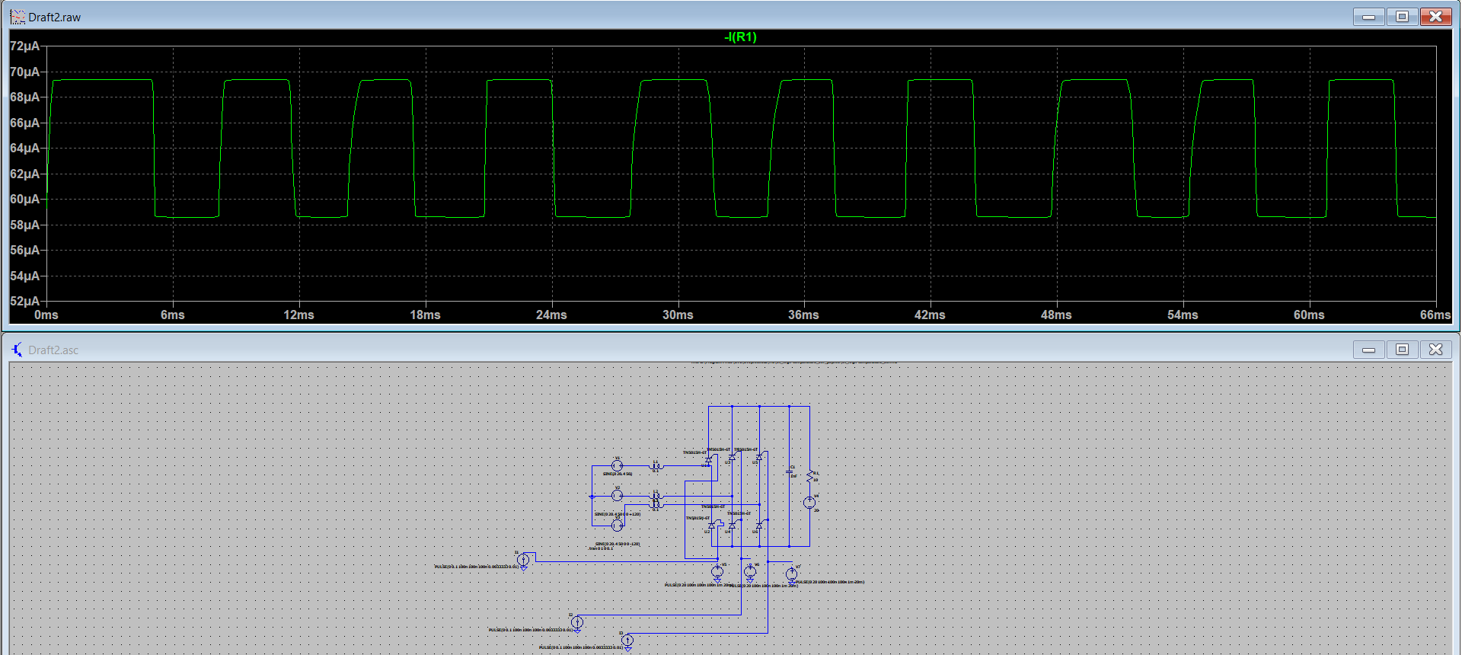
thyristor with pulse.png
