onurtoprak1/EE463_PROJECT/Topology of three-phase diode rectifier + buck converter.PNG

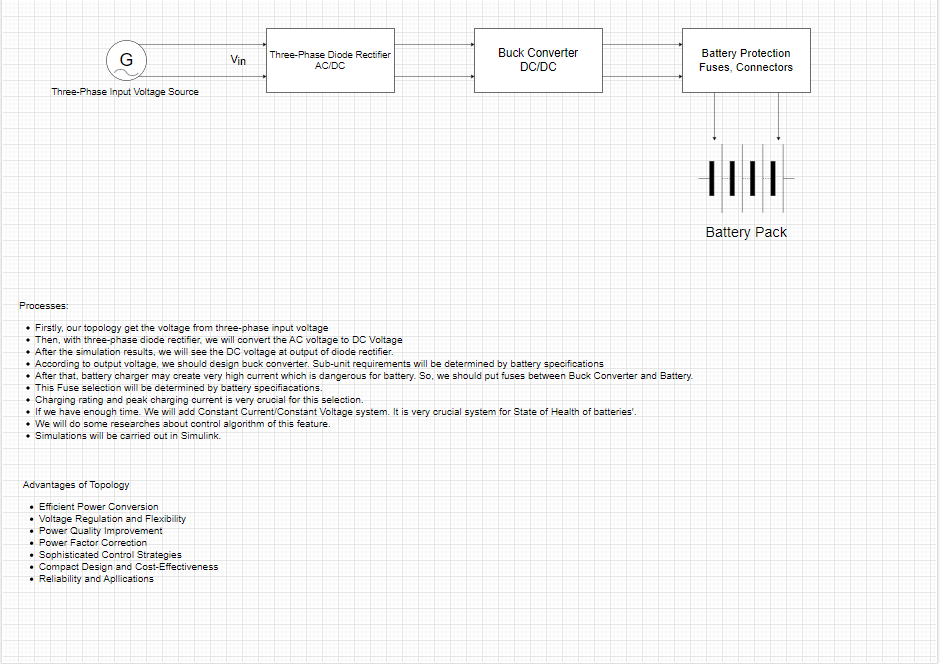
Topology of three-phase diode rectifier + buck converter.PNG
