onurtoprak1/EE463_PROJECT/tyristor with constant current.png

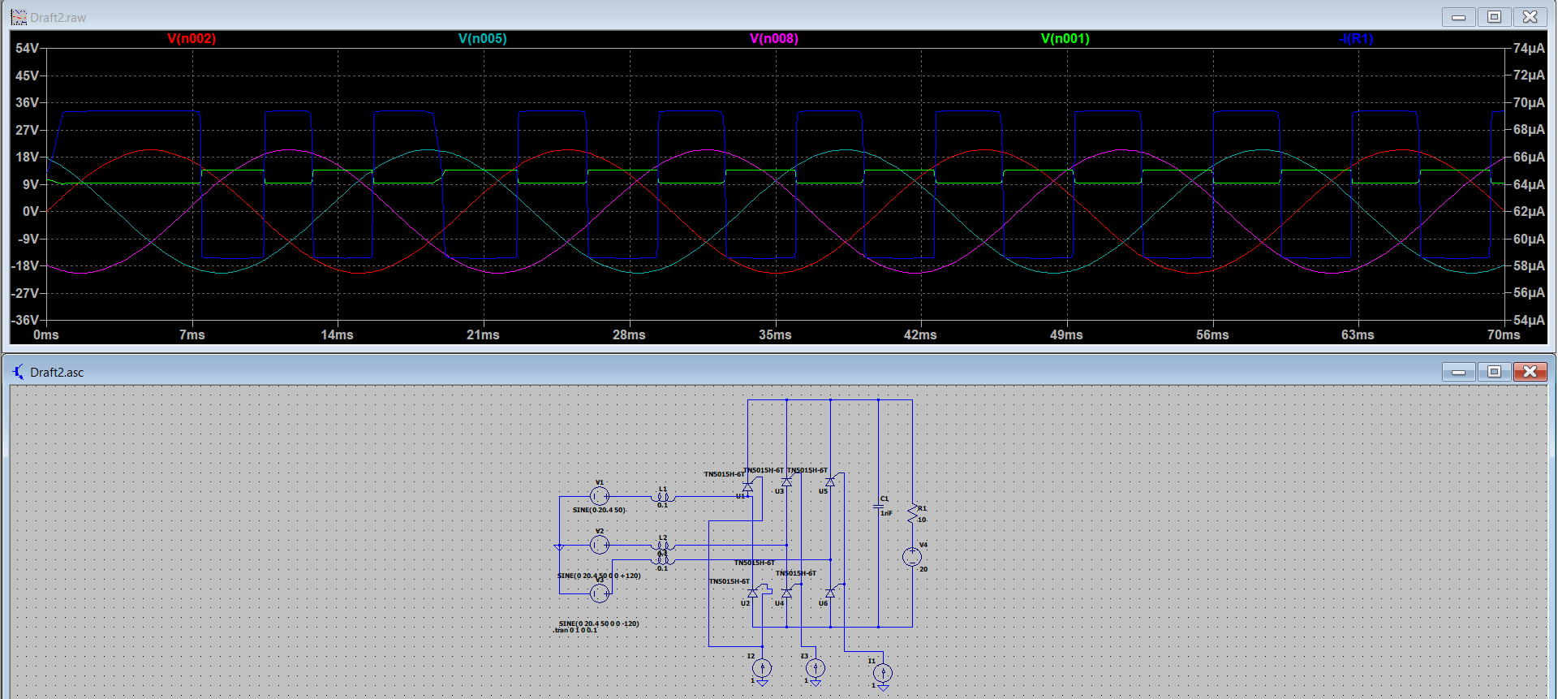
tyristor with constant current.png
