onurtoprak1/EE463_PROJECT/updated simulation.PNG

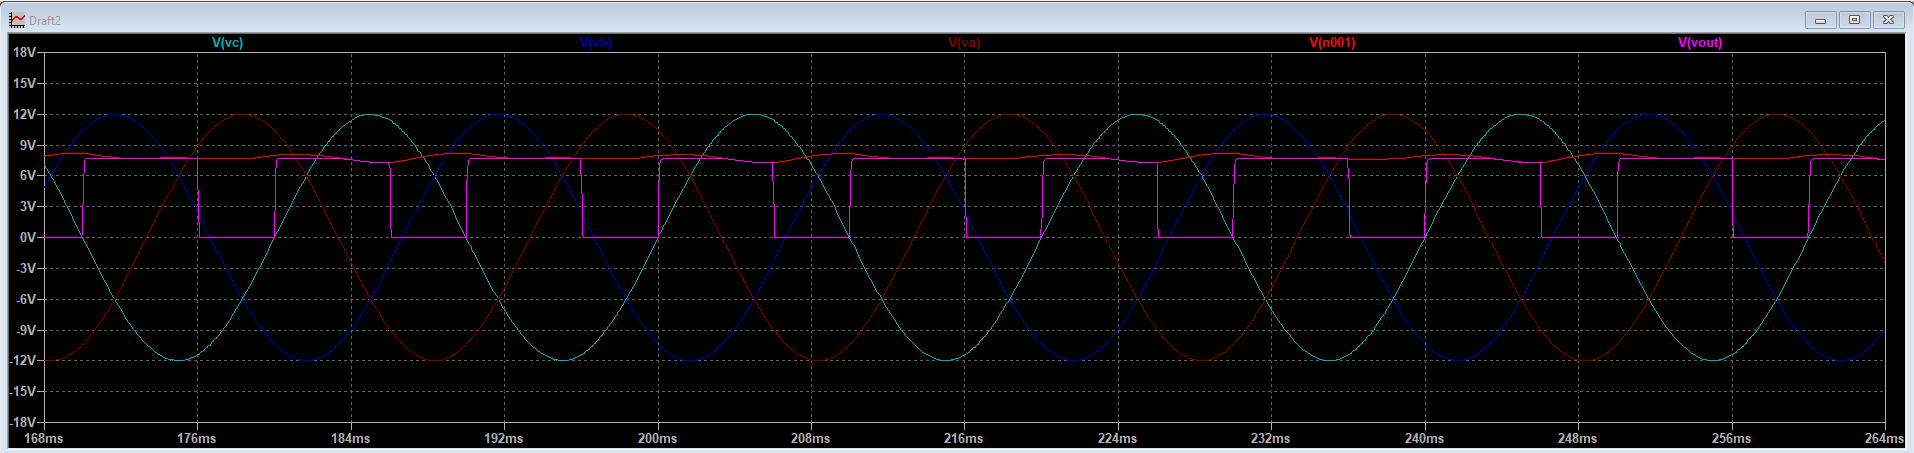
updated simulation.PNG
