onurtoprak1/EE463_PROJECT/Vout simulation results.PNG

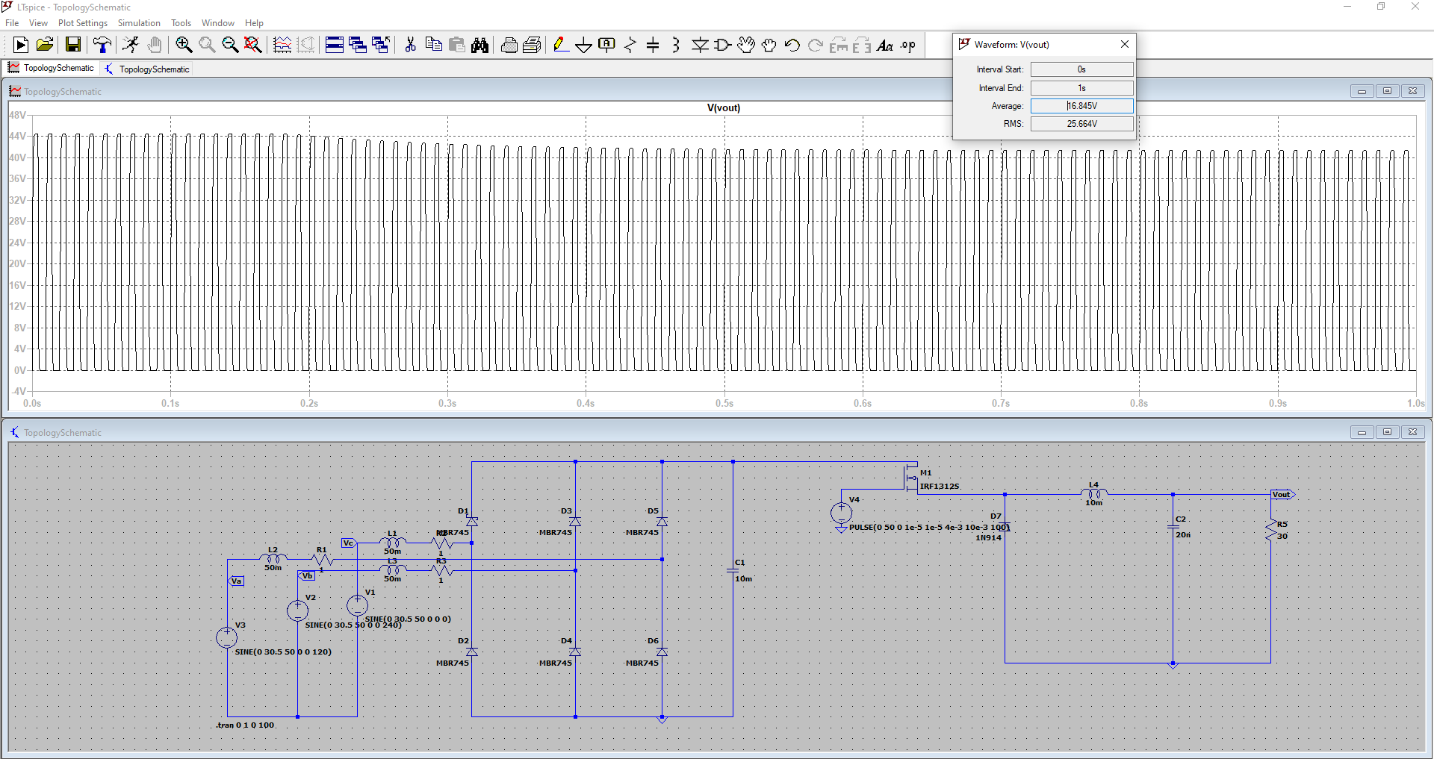
Vout simulation results.PNG
