onurtoprak1/EE463_PROJECT/TopologySchematic.asc

C1: cap; 10m
C2: cap; 20n
D1: schottky; MBR745
D2: diode; MBR745
D3: diode; MBR745
D4: diode; MBR745
D5: diode; MBR745
D6: diode; MBR745
D7: diode; 1N914
L1: ind; 50m
L2: ind; 50m
L3: ind; 50m
L4: ind; 10m
M1: nmos; IRF1312S
R1: res; 1
R2: res; 1
R3: res; 1
R5: res; 30
V1: voltage; SINE(0 30.5 50 0 0 0)
V2: voltage; SINE(0 30.5 50 0 0 240)
V3: voltage; SINE(0 30.5 50 0 0 120)
V4: voltage; PULSE(0 50 0 1e-5 1e-5 4e-3 10e-3 100)
Named nets: 0, Vout, Va, Vb, Vc
.tran 0 1 0 100
