onurtoprak1/EE463_PROJECT/FinalTopology.asc

C1: cap; 20µ
C2: cap; 10µ
D1: schottky
D2: diode
D3: diode
D4: diode
D5: diode
D6: diode
D7: diode
L1: ind; 1m
L2: ind; 1m
L3: ind; 1m
L4: ind; 400µ
M1: nmos; BSC082N10LS
R1: res; 1
R2: res; 1
R3: res; 1
R4: res; 50
R5: res; 30
V1: voltage; SINE(0 20.41 50 0 0 0)
V2: voltage; SINE(0 20.41 50 0 0 240)
V3: voltage; SINE(0 20.41 50 0 0 120)
V4: voltage; PULSE(0 50 0 0.1e-5 0.1e-5 0.25e-4 0.5e-4)
Named nets: 0, Vout, Va, Vb, Vc
.tran 0 0.1 0 100
