onurtoprak1/EE463_PROJECT/Draft2.asc

C1: cap; 1n
D1: diode; 1N914
D2: diode; 1N914
D3: diode; 1N914
D4: diode; 1N914
D5: diode; 1N914
D6: diode; 1N914
L1: ind; 1m
L2: ind; 1m
L3: ind; 1m
R1: res; 1
R2: res; 1
R3: res; 1
R4: res; 50
V1: voltage; SINE(0 12 50 0 0 0)
V2: voltage; SINE(0 12 50 0 0 240)
V3: voltage; SINE(0 12 50 0 0 120)
Named nets: 0, Vout, Vin
.tran 0 0.1 0 100
