onurtoprak1/EE463_PROJECT/(list of files, drawings)

Other design files:
Closed_loop.pdsprj
PWM generator/Project Backups/PWM_controller [20231228, 01-18-46].pdsprj
PWM generator/Project Backups/PWM_controller [20231228, 01-18-48].pdsprj
PWM generator/Project Backups/PWM_controller [20231228, 01-18-49].pdsprj
PWM generator/Project Backups/PWM_controller [20231228, 01-50-30].pdsprj
PWM generator/Project Backups/PWM_controller [20231228, 02-24-18].pdsprj
PWM generator/Project Backups/PWM_controller [20231228, 02-24-20].pdsprj
PWM generator/Project Backups/PWM_controller [20231228, 02-24-27].pdsprj
PWM generator/PWM_controller.pdsprj
