onurtoprak1/EE463_PROJECT/(commit log)

2023-11-16 Add files via upload
    Block diagram of three-phase diode rectifier + buck converter
2023-11-21 Add files via upload
    Three-Phase Diode Rectifier Schematic and Voltage Waveforms with different capacitor values
2023-11-21 Add files via upload
    AC/DC + DC/DC topology schematic and simulation result. It will be updated
2023-12-01 Add files via upload
    Critical component parameters for buck converter
2023-12-01 Add files via upload
    Updated version of simulation and resulted output voltage waveform and average voltage with 0.5 duty cycle
2023-12-02 Topologies
    I added some important toplogies for overall circuit
2023-12-03 UPDATED PWM GENERATOR
2023-12-06 Add files via upload
    Circuit for getting 10 A
2023-12-27 Add files via upload
    DC/DC Buck Converter Design with TL494 PWM Module. Design is done with proteus simulation tool. According to simulation results voltage between 15 V to 35 V, output voltage is adjusted to 13 V.
    [PWM_controller [20231228, 01-18-46].pdsprj, PWM_controller [20231228, 01-18-48].pdsprj, PWM_controller [20231228, 01-18-49].pdsprj, PWM_controller [20231228, 01-50-30].pdsprj, PWM_controller [20231228, 02-24-18].pdsprj, PWM_controller [20231228, 02-24-20].pdsprj, PWM_controller [20231228, 02-24-27].pdsprj, PWM_controller.pdsprj]
2023-12-29 Add files via upload
    Analog Controller Design completed with TL494
    [Closed_loop.pdsprj]
2023-12-30 Add files via upload
    last version of buck converter
    [Closed_loop.pdsprj]
2024-01-23 Simulation results,gate driver and controller are added
2024-01-23 Add files via upload
    last version of the final report with parts schematics and simulation results
